MickGyver/DaemonBite-Retro-Controllers-USB/NESControllersUSB/README.md

# DaemonBite SNES/NES USB Controller adapter
## Introduction
With this simple to build  adapter you can connect NES gamepads to a PC, Raspberry PI, MiSTer FPGA etc. The Arduino Pro Micro has very low lag when configured as a USB gamepad and it is plug n' play once it has been programmed. 

## Parts you need
- Arduino Pro Micro (ATMega32U4)
- Male end of NES controller extension cable
- Heat shrink tube (Ø ~20mm)
- Micro USB cable

## Wiring
Assemble1

## License
This project is licensed under the GNU General Public License v3.0.
