MickGyver/DaemonBite-Retro-Controllers-USB/SegaControllerUSB/images/sega-usb-adapter-parts.png

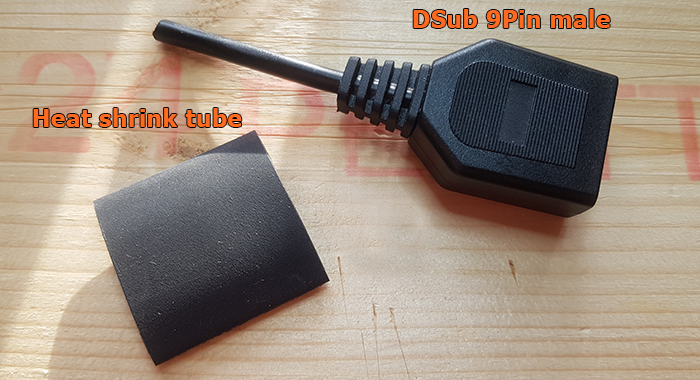
SegaControllerUSB/images/sega-usb-adapter-parts.png
