MickGyver/DaemonBite-Retro-Controllers-USB/(threads)

Thread 3 (2020-07-18):

2 controller limit fix

jroth, 2020-07-18:
I looked into the 2 controller limit issue.

Reference to the hardware limitation here:
https://github.com/NicoHood/HID/wiki/API-Documentation

"The CDC Serial uses 3 endpoints. This means you can add up to 3 devices for the 32u4 and 1 for the 8/16/32u2. If you add more, some will be ignored."

I found a fix, that others have used when creating usb keyboards.  It disables the CDC to free up resources.  https://github.com/gdsports/usb-metamorph/tree/master/USBSerPassThruLine

If we disable CDC like they did, all 4 gamepads work again with the rest of the code unchanged.   I just dropped the modified libraries into my project to avoid any system wide issues with other projects.

Then to upload new code, I just plug in the device, and toggle gnd+reset and the bootloader will accept new code.

MickGyver, 2020-07-19:
Good find!

Closed 2020-09-08.

Thread 4 (2020-07-28):

Has anybody created any 3D printed cases for these adapters?

sofakng, 2020-07-28:
Has anybody designed any 3D printed cases for these DaemonBite adapters?

MickGyver, 2020-09-08:
This is not really an issue with the code,  so I'm closing the issue.

Closed 2020-09-08.

Thread 6 (2020-08-14):

SNES - Latest version of .ino detects 8bitdo SN30 (2.4ghz) as NES controller

italiangrandma, 2020-08-14:
Title. When plugged into MiSTer, the adapter was detecting my wireless SN30 as a NES controller instead of a SNES controller (A, X, L and R did not respond when trying to map). I reverted to the previous version and all is now well.

MickGyver, 2020-08-15:
Someone else made a pull request to fix NES detection, I accepted it without reviewing it properly. I reverted that pull request now.

Closed 2020-09-08.

Thread 8 (2020-09-02):

Feature Request: PC game port (D-Sub 15) support

rmueller83, 2020-09-02:
I have some old Gravis Gamepads & Analog Pro Joysticks, which would be nice to use with MiSTer ao486 or the new MS FlightSim. I found another project which uses the larger Arduino Leonardo which perhaps could be used as a template: https://github.com/shadwork/Arduino-PC-Gameport-HID

MickGyver, 2020-09-08:
Thanks for the heads up! I am working on a PC gameport adapter. I have basic 2-4 analog axis and four button controllers working. The Gravis Gamepad also works. I'm currently working with the Microsoft Sidewinder range.

rmueller83, 2021-05-22:
@MickGyver has the PC gameport support been removed?

Closed 2020-09-08.

Thread 9 (2020-09-03):

How do you wire SNES up for 2 pads support?

shanotype, 2020-09-03:
I done this mod for USB SNES but how do you go about adding another Snes pad to it? Saves me using another board.

MickGyver, 2020-09-08:
All the wires of both the connector are shared except for the data line. Data of port 1 should be connected to DATA1, data of port 2 should be connected to DATA2.

shanotype, 2020-09-08:
Thank you! Makes sense. :)

Closed 2020-09-08.

Thread 10 (2020-09-08):

NES adapter recognized in Win10 but not responding

quaelgeist, 2020-09-08:
Hi guys.

I have wired up the NES adapter and it shows up as two gamepads in win10.
But a confirmed as working NES pad produces no response from any of those two.

Has anybody ever had this problem before?

regards,
Michael

MickGyver, 2020-09-08:
Probably something wrong with the wiring. Did you connect all wires of the connector, including 5V and GND?

quaelgeist, 2020-09-08:
thanks for the answer

Yes, all are connected. latch, clock, gnd, data1 and vcc (thats the 5V, right?)
also created the solder bridge and checked the wires of the extension plug with a multimeter to make sure i wasn't mixing them up. Solder points look and feel solid.

quaelgeist, 2020-09-08:
Well, reproduce me sideways, but after trying yet again, it suddenly works perfectly. I guess it was Windows and not the Arduino that was pulling my leg here all the time :-|

MickGyver, 2020-09-08:
Good to hear it's working! :)

Closed 2020-09-08.

Thread 11 (2021-01-01):

3rd button for DB9 double-triggers or so

dfilskov, 2021-01-01:
Concerning the 3 button specialized version for DB9: When using the third button in combination with one of the other buttons (like a modifier - or vice versa) something wrong happens. It's supposed to produce sth like:
button 2 down
button 3 down
button 2 up
button 3 up
... but it doesn't seem to. I've tested this on MiSTer trying to use it for a 2-button combination for opening the OSD (menu) but it doesn't work - other USB joysticks do but not the 3 button version of the DB9 firmware.

Thread 12 (2021-03-08):

Could you make one for the Nintendo classic connector

aihooo444, 2021-03-08:
Not a Issue but a feature request.
I would love to use my Official Nes Mini Controllers

asturur, 2021-03-29:
I have the same whish and i noticed that the controllers seems to be based on an i2c bus at 400khz.
Does this help to understand if is doable or not?

Klausus, 2021-04-28:
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

All the classic controller I2C timing is measured with SNES Classic Mini (I2C speed is 200KHz).

Some non-official classic controller (like PS2 to classic controller) need 200KHz speed, official one can run with 300KHz.

But both can not work properly with 400KHz speed.

**Note:**  This info is extracted from this Github Project: https://github.com/splash5/arduino_classic_controller_to_snes

Klausus, 2021-04-28:
**It is possible, but I don't know the lag it may have.**
Exists implementations made in arduino and there are also entire libraries dedicated to only connect Wii/ClassicMini I2C controllers.

**For example:**

Wii Classic controller to SNES interface:
https://github.com/splash5/arduino_classic_controller_to_snes

Library 1 (older):
https://github.com/madhephaestus/WiiChuck

Library 2 (more newer):
https://github.com/dmadison/NintendoExtensionCtrl

Example of usb interface with arduino for 1 classic controller:
https://www.instructables.com/USB-Wii-Gamepad-Using-Arduino-Leonardo/

The libraries have support for many extra peripherals that are not needed (nunchuck, guitar hero, taiko drums etc) and I don't know how much it could affect to minimize input lag.

We need to make an implementation that allows to connect 2 classic controllers of Wii or NES/SNES Classic Mini, minimizing the lag as much as possible.

@MickGyver  Could you check it out when you have time?

PD:  Sorry if English is not perfect (My native language is Spanish). Translated with Deepl.

Thanks.

mbaran5, 2021-06-06:
> We need to make an implementation that allows to connect 2 classic controllers of Wii and NES/SNES Classic Mini

My understanding of the way these are setup, the i2c address for all classic controllers is the same, and is not able to be changed. This would require external hardware to the pro micro (a i2c multiplexer) otherwise they'd appear as the same device on the i2c bus if both connected.

That said, I would love to see support for the Classic controllers as the quality of the real Nintendo ones is high and they'd be great to use with this.

asturur, 2021-06-07:
one controller per arduino would be cool enough. as of today an extension cord to cut to create the female port is more expensive than the arduino 🤷‍♂️

Thread 14 (2021-03-19):

NeoGeoControllerUSB README Documentation

cturczynskyj, 2021-03-19:
You probably already know this but the NeoGeoControllerUSB project doesn't have wiring documentation. I looked in the NeoGeo source files in hopes of trying to write it myself but I could not figure out the mapping from the source. Not really an issue but a humble request. Thanks for the hard work!

Klausus, 2021-04-28:
@MickGyver create a read.me for NeoGeoControllerUSB Folder with the info and image similar to NES/SNES/SEGA etc folders.
You've found the image wiring connection for neogeo in your other project --> https://github.com/MickGyver/DaemonBite-Arcade-Encoder

Thread 17 (2021-04-01):

Inline adapter to add Atari 7800 support

0x15e, 2021-04-01:
With Atari 7800 support for MiSTer maturing, I picked up an Atari Proline controller to use with it. Unfortunately, since the 7800 controller is kind of an odd bird due to its backwards compatibility with the 2600, it can't be used with any of the DE9 controller adapters (e.g., the Sega ones) as-is.

With most of the controllers, input is held high and pulled low by the input. The 7800 controller, however, keeps the individual button inputs held low by resistors in the controller and pressing them pulls them high (to 5V). The pins also don't line up 100% with other 2-button controllers like the Master System.

So, in an attempt to solve the problem, I'm going to try building an inline adapter to go between the 7800 controller and my Sega Daemonbite adapter. The plan is to use an inverting buffer (the CD4049 specifically) to invert the logic levels on the two fire buttons while passing the rest of the pins through such that the 7800 controller behaves like a Master System controller (with the common 1-button fire functionality disabled).

The CD4049 is supposed to draw very little current so I don't think this will ruin the Arduino but I'd appreciate a second set of eyes on this to tell me if I'm on the right track.

Here's the schematic for the as-yet unbuilt and untested adapter (the male side connects to the 7800 controller, female side to the Daemonbite Sega adapter):

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

0x15e, 2021-04-04:
OK I can say for sure that this circuit does not work as intended. It doesn't damage anything and does manage to invert the logic correctly _but_ it doesn't allow the buttons to operate separately (pressing either button triggers both outputs). So back to the drawing board.

0x15e, 2021-04-04:
I'm definitely stuck now. I rebuilt the adapter using transistors. It works in Spice. It works on the breadboard. But when I plug it into the Sega adapter, it still sees both buttons being triggered when I only press one.

It seems I'm missing something fundamental here but I can't figure out what. Anyway, this is probably off-topic for this project at this point so I'm going to close the issue.

0x15e, 2021-04-05:
Just one more comment. It turns out the problem was with my 2x Sega adapter. On the 1p port, everything works great. On the 2p port, an SMS controller (even a real one) triggers both buttons when either is pressed, and a Genesis controller triggers A+Start when either A or Start is pressed and B+C when either of B or C is pressed.

So maybe that first circuit (with the CD4049) _did_ fry something after all, but the good news is that the second version with transistors works beautifully. Just gotta rebuild my 2x Sega adapter now ... :(

0x15e, 2021-04-05:
Last comment, I swear. It turns out the problem was shoddy workmanship on my part. There was a short between pins 14 and 15 (i.e., the pins that would connect to the problematic buttons) on the Arduino. Talk about making me feel like an idiot. Maybe I should've tested both ports on my Sega adapter when I built it. :D

Anyway, regarding the two 7800 adapter approaches, the CD4049 approach is probably fine but also overkill. The 7800-to-SMS adapter can be done with 2 NPN transistors, 2 1.8KΩ resistors, and 2 270Ω resistors. I'll probably whip something up in KiCad in the near future that can be used to build it and fits inside a standard DE9 gender changer hood, and post it on OSHPark.

Closed 2021-04-04.

Thread 18 (2021-04-28):

Problem with a 6 buttons megadrive controller

blc29seb, 2021-04-28:
Hi
I made the controller adapter for megadrive (SegaTwoControllersUSB)
tested under windows 10 with the windows game controller application
i have several problems

I use an official 6 buttons controller and an official 3 buttons
in 3 buttons mode everything works fine (even with the 6 buttons controller configured in 3 buttons (mode button))
but in 6 buttons mode when I use the Dpad I have some buttons that are activated (4,5,6,8,9)
for example (left +down):
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

and when I push on the x (4) y(5) or z(6) buttons they blink instead of staying on  like A,B and C buttons

What does the button 9 correspond to when there are only 8 buttons ?
Sincerely (sorry for my bad english ;) )

MickGyver, 2021-05-06:
I guess there is something with your wiring/soldering is causing this issue.

Button 9 corresponds to the HOME button on the 8bitdo M30 2.4G wireless MD/Genesis controller.

venice1200, 2021-05-06:
Using your "SegaControllerUSB" Sketch.

My two Sega 3 Button Controllers Model 1650 and 1650-50 are working fine.
My Sega 6 Button Controller Model SJ-6000 doesn't work at all.

Any Idea's?

blc29seb, 2021-05-09:
Hi
It's not a problem of welding or anything else
I checked everything
and with this code (https://github.com/thinghacker/DualUSBSegaController/tree/master/examples/DualUSBSegaController)
 it works fine but I can't use your TX1 and RX0 connections
I will have to redo my soldering to wire them on other ports
Best regards

venice1200, 2021-05-12:
Just a note, I got my 8BitDo Genesis M30 2.4g Controller whioch works perfect with the "SegaControllerUSB" Sketch. Really cool.

Need to double check why the Sega 6 Button Controller Model SJ-6000 doesn't work at all.
I will try it with the MiSTer's USB 3.0 based Snac Adapter next week.

MickGyver, 2021-05-13:
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
Please try the "SegaControllerUSB" sketch in this branch:

https://github.com/MickGyver/DaemonBite-Retro-Controllers-USB/tree/SEGA-6-Button

venice1200, 2021-05-13:
Tested. Nothing better with Sega 6 Button. No function at all.
And from the 8BitDo Genesis M30 2.4g only Buttons ABC and Start are working.

MickGyver, 2021-05-13:
> Tested. Nothing better with Sega 6 Button. No function at all.
> And from the 8BitDo Genesis M30 2.4g only Buttons ABC and Start are working.
> Back on "Main".

Yes, I just noticed it was a stupid attempt at a fix, I will look at it some more when I have the time.

venice1200, 2021-05-14:
No hurry...

gregdick1, 2021-07-07:
I've run into a similar problem with my SegaTwoControllersUSB adapter and the retro-bit official 6 button controllers. Without pressing anything, x or y will fire seemingly randomly.
I made two adapters. They both behave the same. They work perfectly with an original 3 button controller and with some non-branded cheap 6 button controllers I got off of ebay. Very interesting that the cheap one works fine. I don't have an original 6 button to try.

I also tried the SegaControllerUSB with 6 button hack on your other branch. Then both non-branded and retro-bit 6 button controllers only had the dpad, A, B, C, and Start working.

Jmaxime89, 2021-09-24:
Hello I'm wondering if there is any development on this ? I only have original 6 button controllers and they don't work on the two daemon bite I've made for the mister

quidamphx, 2021-09-29:
I have similar issues, which led me to double check my wiring.

I'm using MiSTer input test, and Windows 10 USB Game controller properties.

I wonder if this issue is somehow related to device IDing? When I have Player 1 connected with a 2.4Ghz 8bitdo controller, it works perfectly. When I add another receiver to Player 2, it causes sporadic inputs on Player one.

When I connect an OEM Genesis 1650 as Player 2 (still with the 8bitdo as Player 1), both function correctly. Narrowing it down, either it's getting confused by 2 controllers that are the same, or something related to the XYZ of Player 2.

If I knew more about the coding I'd look into it, but I can say there's an issue with Player 2 using 6 button, OR controllers being ID'd as the same.

quidamphx, 2021-09-30:
Yeah, it's puzzling for sure. I don't have a Sega-branded 6 button to try,
but I can say for certain that there's issues with using my 2x M30
controllers together.

If there's any more testing I can do to help narrow it down, I'd be happy
to.

I'm repeating myself a bit, but the Player 2 controller works perfectly if
it's the only one plugged in (nothing in P1 spot), but with them both
8bitdo, I can't get anything to trigger in the P2 spot at all (and it
causes issues with P1 as mentioned), until I use a different controller.
Then it, and P1 work perfectly.

That said, the NES version I built works perfectly with 2x 8bitdo
controllers, and so does the SNES version.

Tom

On Thu., Sep. 30, 2021, 1:13 p.m. Jmaxime89, ***@***.***>
wrote:

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

emarleau, 2021-10-09:
I would like to point out that the issue with the Retro-Bit 6 button controller is also happening with the SNAC adapter.
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

emarleau, 2021-10-09:
Genesis core. I'm using a test rom called Sega Genesis 6 button controller test https://www.romhacking.net/homebrew/126/

treeswithhumanfaces, 2022-03-09:
I was able to fix this for retro-bit officially licensed controllers by commenting out the code that captures home button input.

Lines 162 and 234 in SegaControllers32U4.cpp

gregdick1, 2022-08-21:
@treeswithhumanfaces I tried commenting those two lines, but it didn't fix the problem for my retro-bit controllers. Did you have any other changes you experimented with that might've gotten it working?

Thread 19 (2021-06-11):

[Q] connect multiple controllers to the same Arduino

eadmaster, 2021-06-11:
is this possible by using different pins for the data cables while sharing the same power pins?

Obviously i will be using one controller at a time.

eadmaster, 2021-08-30:
just found a pad detection routine here that could be re-used:
https://github.com/bootsector/LLAMA/blob/master/firmware/Input/Input.c#L161

Thread 20 (2021-06-12):

Dreamcast controller support

eadmaster, 2021-06-12:
The Dreamcast controller runs at 5V natively, so there is no need for level shifting.

Possible libraries to use:

- https://github.com/Xerxes3rd/libmaple
- https://github.com/ismell/maplebus

ShdwDncR, 2025-01-21:
How do I go about building a Arduino/USB adapter for a Dreamcast controller ? thx

Thread 27 (2022-08-14):

NES with Turbo A and B

alchle, 2022-08-14:
Hello MickGyver.  I have a "original" NES controller with 10 buttons (up, down, left, right, select, start, A, B, Turbo A, Turbo B.  Looks just like the regular NES controller and just as old too, but with the two turbo buttons. I tried the code, tried modifying to 10 buttons, kept at 8 as well (thinking the internal chip does the "turbo" logic).  Wire colors are the same as an original NES.  Gamepad shows up, but the buttons do not register in the Game controller control window (joy.cpl).  When changing the 8 to 10 for number of buttons, in still only see the 4 buttons in the gamepad window.  Tried adding two more spots here (not sure what to change them to) uint8_t btnBits[BUTTON_COUNT] = {0x20,0x10,0x40,0x80,UP,DOWN,LEFT,RIGHT};  I haven't had any luck.  Was originally going the Raspberry Pi Pico route (got that working with Atari) but didn't was to cut up the NES circuit board to map to keyboard buttons.  I'd like to made it an actually gamepad vs keyboard.  Any help?  Thanks

Thread 28 (2022-09-27):

NES PAL original controller vs NES clonic controller

sromeroi, 2022-09-27:
I sharing the same Arduino proMicro for a SNES-to-USB and NES-to-USB daemonbyte: the arduino is connected to a male DB9 connector and my NES and SNES adaptors are connected to the arduino with a female DB9 connecting DATA1, DATA2, CLOCK, LATCH, GND and VCC properly.

The SNES controllers work perfectly both original and clonics.

The NES controllers are also detected in the PC as a 2 axes, 8 buttons controller.

My "clonic" NES controllers work perfectly (-32767 to +32767 on axes, and A and B in button 0 and 2).

But my original PAL NES controllers report buttons 1, 3, 4, and 5 as pressed, making me impossible to use the controller in setups where I have also configured actions for those extra buttons.

Is it maybe because of region protection or something like that? Is it possible to fix this via software without forcing manually in the code buttons 1,3,4,5 = 0 (that would break the SNES controller setup)?

Please see screenshots attached to clarify the issue.

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

sromeroi, 2022-09-28:
Maybe this would fix my PAL controller to work with DaemonBite NES adapter?

https://www.youtube.com/watch?v=0xYpettDwL0

Thread 30 (2022-11-23):

pico pi

patitogit, 2022-11-23:
can it be ported to pico pi?

iamseriodotus, 2024-03-07:
I'm not sure if I am doing something wrong but on my raspberry pi I can't get the direction inputs to register at all.

SergiyIva, 2025-03-23:
You not have otg usb on pico. Also you can find information about ftdi standart.

Thread 31 (2023-03-21):

Colour coded SNES connector diagram, USB C pro micro support

danboid, 2023-03-21:
Hi MickGyver

I think it would be useful to colour code the SNES pad diagram to use the colours used by most SNES pads and extension cables but I'm not sure if they differ from the colours used by NES pads?

I've done a quick hack job of making those adjustments to the labels on SNES pic that you probably won't want to use but here it is anyway:

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

Also, Amazon sell a USB C version of the Arduino Pro Micro. I presume we can use them instead of Micro USB version of the Pro Micro? I realise it won't be any faster, not that it matters, but I prefer the reversable nature of USB C.

Thanks for the great project!

danboid, 2023-03-25:
I have successfully built and tested this adapter using a USB C Pro Micro so you may want to update the README to mention that this is a option for those that might prefer to use USB C.

EmiFanshi, 2024-07-19:
Thank you very much. I had doubts until I found your comment. Thank you so much.🎀💗

Thread 32 (2023-12-11):

Solder bridge when creating SaturnControllerUSB?

yayoi-k, 2023-12-11:
Thank you for this great project.  Question:
Most of the projects (SNES, NES, Sega) indicate the solder bridge needs to be done.  However this is not mentioned at all with the SaturnControllerUSB.  The SaturnControllerUSB instructions are also much more sparse and lack the images that the other projects contain (images which re-iterate the solder bridge).

Could it be clarified wether the solder bridge is required for the SaturnControllerUSB?

https://github.com/MickGyver/DaemonBite-Retro-Controllers-USB/tree/master/SaturnControllerUSB

Thank you!

yayoi-k, 2023-12-11:
I researched and Saturn controllers require 5v, and the solder bridge creates a short such that the voltage output will be 5v.  So the solder bridge should be done on the Saturn Controller implementation.

Closed 2023-12-11.

Thread 33 (2023-12-11):

Hyperkin GN6 Sega Genesis 6 Button Controller Support

ZachHazen, 2023-12-11:
Testing the two controller USB Genesis Adapter

With a sega branded 3 button controller, all of the inputs work: (D-Pad, start, ABC)
With a Hyperkin GN6 6 button controller (works fine on console), only The D-Pad and the BC buttons work.  Start, A, mode, and XYZ do not work.

Tested on windows with gamepad properties and on a Mister.  Tested with two different GN6 controllers and a single OG genesis controller.

Checked pin outs with a multimeter and everything looks good.  Used arduino IDE to upload the latest sketch.

Need to get an official sega 6 button controller to test more, but I wanted to check in here to see if there were any ideas.  The Hyperkin GN6 is a great alternative to aging controllers that have gone mushy, and they work fine on console.  Curious if there are any reasons why the adapter might see it differently.

ZachHazen, 2023-12-11:
I should add the GN6 works great on the Mister with SNAC.  Genesis SNAC/X is limited to single player, so I got a daemonbyte adapter specifically to play two player games.

ZachHazen, 2023-12-11:
I'm semi-consistently able to get the start button to register (button 7) by holding start (nothing happens), hitting B, releasing B (start comes on).  Its not every time...

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

ZachHazen, 2023-12-17:
Tested two OG Genesis 6 button controllers.  While I got them to work eventually, I did have a few moments where they were acting like the Hyperkins - no A, X,Y,Z or start.  Plugging them out and in again seemed to fix it?  ~1 hr of gunstar heros on the Mister + CRT felt perfect with 2 players.

darylrichards, 2023-12-22:
I've been working through the code, and have a version that works 95% on these Hyperkin units. I've tested them and a normal Atari joystick, and they both work fine. Only oddity so far is that the X,Y,Z buttons seems sticky. If I press one of them, then A,B or C, the XYZ sticks until the ABC is released... I'm away for the next week so I'll let someone else see what they can..

[SegaTwoControllersUSB.zip](https://github.com/MickGyver/DaemonBite-Retro-Controllers-USB/files/13747148/SegaTwoControllersUSB.zip)

Sorry, my Git-fu is lacking to get this up here easier..

Thread 34 (2024-02-04):

I would like to use Atari's PADDLE on the CD32controllerUSB, currently the buttons work but the potentiometers do not work.

Tico80, 2024-02-04:
Hello, I would like to use Atari's PADDLE on the CD32controllerUSB, currently the buttons work but the potentiometers do not work. The potentiometers are 1Mega and the result should be to go from right (1Mega) to left (0Mega) for example in the BREAKOUT game.

Closed 2024-02-04.

Thread 35 (2024-02-04):

Hello, I would like to use Atari's PADDLE on the CD32controllerUSB, currently the buttons work but the potentiometers do not work.

Tico80, 2024-02-04:
Hello, I would like to use Atari's PADDLE on the CD32controllerUSB, currently the buttons work but the potentiometers do not work. The potentiometers are 1Mega and the result should be to go from right (1Mega) to left (0Mega) for example in the BREAKOUT game.

Thread 37 (2024-12-23):

[REQUEST] Reverse SegaControllerUSB (= connect USB keyboards as DB9 joysticks)

sromeroi, 2024-12-23:
After the release of the MSX's Arrow Pad controller (a mechanical 6 keys keyboard with DB9 connector, having just arrows + 2 fire buttons), I've been thinking that it would be interesting to connect USB keyboards as "DB9 joysticks" (Atari pinout, like Sega Master System's, MSX or a Sinclair Spectrum Kempston Joystick).

Could you provide the possibility to build SegaControllerUSB as USBControllerSega, with a male DB9 connector?

It would read the keyboard and translate keys into UP, DOWN, LEFT, RIGHT, FIRE1, FIRE2 and FIRE3, with the keys configured in the Arduino source code as arrays of keys that provide that output (i.e., in pseudocode):

up_keys = [ 'q', 'i', .... ]      // or scancodes?
down_keys = ...
...

This would allow also to use macro keyboards (like 3x3 or 6x3 keyboards) as small "keyboard joysticks" for computers that have DB9 joysticks and faulty or bad keyboards (like the Sinclair Spectrum's rubber keyboard, which is not very good for gaming).

Instead of supporting multiple different keycodes for up/down/left/right, It could instead support multiple keyboard schemas defined in the code, switchable by 3 keys (scheme_reset to #0, scheme_up and scheme_down), like having "IJKL cursors + QWE" as #0 and "OPQA + M" as #1.

Thanks and best regards.

Thread 38 (2025-04-29):

SegaControllerUSB switch function

danko79, 2025-04-29:
Hi, designed a PCB for the SegaControllerUSB firmware, but I didn't understand what the switch is for, could you tell me its function?

Thread 39 (2025-05-12):

TG16 PCB

InOverMyHead67, 2025-05-12:
I'm attempting to make a PCB for the TG16, but I've never made a PCB before :).  This uses the more generic DIN-8 adapter, which I'm hoping will work?  Any feedback would be appreciated.  Feel free to make tweaks to make general recommendations as well.  I need to add mounting holes at the very least.

Thanks!

[PC Engine Daemonbite Adapter V1.zip](https://github.com/user-attachments/files/20176594/PC.Engine.Daemonbite.Adapter.V1.zip)

Closed 2025-05-18.

Thread 40 (2025-05-18):

TG16 Only Recognizes D-Pad

InOverMyHead67, 2025-05-18:
I ended up hard wiring plugs for a TG16 adapter, but it appears only the d-pad registers.  That kinda makes sense based upon the wiring, but I figured the Arduino would differentiate.  Have I done something wrong?  Thanks!

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
