MickGyver/DaemonBite-Retro-Controllers-USB/NeoGeoControllerUSB/NeoGeoControllerUSB.ino

/*  NeoGeo Controller to USB
 *  Author: Mikael Norrgård <mick@daemonbite.com>
 *
 *  Copyright (c) 2020 Mikael Norrgård <http://daemonbite.com>
 *  
 *  GNU GENERAL PUBLIC LICENSE
 *  Version 3, 29 June 2007
 *  
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
 */

#include "Gamepad.h"

#define DEBOUNCE 1          // 1=Diddly-squat-Delay-Debouncing™ activated, 0=Debounce deactivated
#define DEBOUNCE_TIME 10    // Debounce time in milliseconds
//#define DEBUG             // Enables debugging (sends debug data to usb serial)

const char *gp_serial = "NeoGeo to USB";

Gamepad_ Gamepad;           // Set up USB HID gamepad
bool usbUpdate = false;     // Should gamepad data be sent to USB?
bool debounce = DEBOUNCE;   // Debounce?
uint8_t  pin;               // Used in for loops
uint32_t millisNow = 0;     // Used for Diddly-squat-Delay-Debouncing™

uint8_t  axesDirect = 0x0f;
uint8_t  axes = 0x0f;
uint8_t  axesPrev = 0x0f;
uint8_t  axesBits[4] = {0x10,0x20,0x40,0x80};
uint32_t axesMillis[4];

uint8_t buttonsDirect = 0;
uint8_t buttons = 0;
uint8_t buttonsPrev = 0;
uint8_t buttonsBits[8] = {0x01,0x02,0x04,0x08,0x10,0x20,0x40,0x80};
uint32_t buttonsMillis[12];

#ifdef DEBUG
  char buf[16];
  uint32_t millisSent = 0;
#endif

void setup() 
{
  // Axes
  DDRF  &= ~B11110000; // Set A0-A3 as inputs
  PORTF |=  B11110000; // Enable internal pull-up resistors

  // Buttons
  DDRD  &= ~B10011111; // Set PD0-PD4 and PD7 as inputs
  PORTD |=  B10011111; // Enable internal pull-up resistors
  DDRB  &= ~B01111110; // Set PB1-PB6 as inputs
  PORTB |=  B01111110; // Enable internal pull-up resistors
  DDRC  &= ~B01000000; // Set PC6 as input
  PORTC |=  B01000000; // Enable internal pull-up resistors

  // Debounce selector switch (currently disabled)
  DDRE  &= ~B01000000; // Pin 7 as input
  PORTE |=  B01000000; // Enable internal pull-up resistor

  // Initialize debouncing timestamps
  for(pin=0; pin<4; pin++)
    axesMillis[pin]=0;
  for(pin=0; pin<12; pin++)   
    buttonsMillis[pin]=0;

  #ifdef DEBUG
    Serial.begin(115200);
  #endif
}

void loop() 
{
  // Get current time, the millis() function should take about 2µs to complete
  millisNow = millis();

  for(uint8_t i=0; i<10; i++) // One iteration (when debounce is enabled) takes approximately 35µs to complete, so we don't need to check the time between every iteration
  {
    // Read axis and button inputs (bitwise NOT results in a 1 when button/axis pressed)
    axesDirect = ~(PINF & B11110000);
    buttonsDirect = ~((PIND & B10011111) | (PINC & B01000000) | ((PINB & B00000010) << 4));

    if(debounce)
    {
      // Debounce axes
      for(pin=0; pin<4; pin++)
      {
        // Check if the current pin state is different to the stored state and that enough time has passed since last change
        if((axesDirect & axesBits[pin]) != (axes & axesBits[pin]) && (millisNow - axesMillis[pin]) > DEBOUNCE_TIME)
        {
          // Toggle the pin, we can safely do this because we know the current state is different to the stored state
          axes ^= axesBits[pin];
          // Update the timestamp for the pin
          axesMillis[pin] = millisNow;
        }
      }
      
      // Debounce buttons
      for(pin=0; pin<8; pin++)
      {
        // Check if the current pin state is different to the stored state and that enough time has passed since last change
        if((buttonsDirect & buttonsBits[pin]) != (buttons & buttonsBits[pin]) && (millisNow - buttonsMillis[pin]) > DEBOUNCE_TIME)
        {
          // Toggle the pin, we can safely do this because we know the current state is different to the stored state
          buttons ^= buttonsBits[pin];
          // Update the timestamp for the pin
          buttonsMillis[pin] = millisNow;
        }
      }
    }
    else
    {
      axes = axesDirect;
      buttons = buttonsDirect;
    }
  
    // Has axis inputs changed?
    if(axes != axesPrev)
    {
      // UP + DOWN = UP, SOCD (Simultaneous Opposite Cardinal Directions) Cleaner
      if(axes & B10000000)
        Gamepad._GamepadReport.Y = -1;
      else if(axes & B01000000)
        Gamepad._GamepadReport.Y = 1;
      else
        Gamepad._GamepadReport.Y = 0;
      // UP + DOWN = NEUTRAL
      //Gamepad._GamepadReport.Y = ((axes & B01000000)>>6) - ((axes & B10000000)>>7);
      // LEFT + RIGHT = NEUTRAL
      Gamepad._GamepadReport.X = ((axes & B00010000)>>4) - ((axes & B00100000)>>5);
      axesPrev = axes;
      usbUpdate = true;
    }
  
    // Has button inputs changed?
    if(buttons != buttonsPrev)
    {
      Gamepad._GamepadReport.buttons = buttons;
      buttonsPrev = buttons;
      usbUpdate = true;
    }
  
    // Should gamepad data be sent to USB?
    if(usbUpdate)
    {
      Gamepad.send();
      usbUpdate = false;

      #ifdef DEBUG
        sprintf(buf, "%06lu: %d%d%d%d", millisNow-millisSent, ((axes & 0x10)>>4), ((axes & 0x20)>>5), ((axes & 0x40)>>6), ((axes & 0x80)>>7) );
        Serial.print(buf);
        sprintf(buf, " %d%d%d%d", (buttons & 0x01), ((buttons & 0x02)>>1), ((buttons & 0x04)>>2), ((buttons & 0x08)>>3) );
        Serial.println(buf);
        millisSent = millisNow;
      #endif
    }
  }
 
}
