MickGyver/DaemonBite-Retro-Controllers-USB/(commit log)

2020-01-30 Removed the need for the switch.
2020-03-02 Small change to Sega two controller adapter wiring.
    Small change to Sega two controller adapter wiring. Wiring diagrams added for Sega two controller adapter and NES/SNES adapters.
2020-05-11 Probably fixed the "going-to-sleep" bug for the SNES adapter
    [Gamepad.cpp, SNESControllersUSB.ino]
2020-05-11 Small fix to the CD32 controller adapter.
    [CD32ControllerUSB.ino]
2020-06-28 PC Engine / Turbografx-16 adapter, Saturn adapter bug fix
    [Gamepad.cpp, Gamepad.h, PCEngineControllerUSB.ino, SaturnControllerUSB.ino, SegaTwoControllersUSB.ino]
2020-07-31 Fix for detecting NES controllers
    My adapter was always detecting my NES controllers as SNES, and this seemed to fix it for me.
    [SNESControllersUSB.ino]
2020-08-15 Revert "Fix for detecting NES controllers"
    [SNESControllersUSB.ino]
2020-09-07 SEGA adapters now support 8bitdo HOME button. NeoGeo adapter added. Forced two-button mode added to CD32 adapter.
2021-05-11 NeoGeo adapter supports buttons on pins 2 and 10.
2021-06-04 Fixed a bug for the SNES adapter (+small optimization)
    [SNESControllersUSB.ino, SNESNTTControllersUSB.ino]
